winsonlin8/SpinnyKittyCommittee/ESP32/README.md

# ESP32 Firmware

This directory contains the PlatformIO project for the ESP32 microcontroller.
The firmware streams a WAV audio file and a synchronized motor/LED control file
from an SD card. Audio goes to the MAX98357A amplifier over I2S; control frames
are forwarded to the MSPM0G3507 over I2C.

## Prerequisites

- [VS Code](https://code.visualstudio.com/) with the [PlatformIO IDE extension](https://marketplace.visualstudio.com/items?itemName=platformio.platformio-ide), **or**
- PlatformIO CLI: `pip install platformio`

## Directory Structure

```
ESP32/
├── src/
│   └── main.cpp       # Full audio + control playback firmware
├── include/           # Project-level header files
├── lib/               # Local libraries
├── test/              # Unit tests
└── platformio.ini     # PlatformIO project configuration
```

## SD Card File Layout

Place these files in the root of a FAT32-formatted microSD card:

| File | Description |
|---|---|
| `/song.wav` | 44.1 kHz, 16-bit, mono PCM WAV |
| `/song.ctrl` | Binary control file — generated by `Audio Characterization/spinny_kitty_spinning_testing.py` |

The control file starts with a 16-byte `CtrlHeader` (`"CTRL"` magic, version,
frame count, frame interval in µs), followed by 5-byte `ControlFrame` structs
at 20 ms intervals. See `src/main.cpp` for the struct definitions.

## Building and Uploading

### VS Code

1. Open the `ESP32/` folder as your workspace root in VS Code.
2. PlatformIO will auto-detect `platformio.ini` and configure the project.
3. Use the bottom toolbar:
   - **Checkmark (✓)** — Build
   - **Right arrow (→)** — Upload

### CLI

Run these commands from inside the `ESP32/` directory:

```bash
pio run              # Build only
pio run -t upload    # Build and upload
```

## Serial Monitor

The firmware outputs debug info over serial at **115200 baud**. To view it:

```bash
pio device monitor
```

Or click the plug icon in VS Code's bottom toolbar.

## Wiring

### ADA254 — MicroSD Card Breakout (SPI)

| ADA254 Pin | ESP32 Pin | Notes |
|---|---|---|
| 3V | 3.3V | Power |
| GND | GND | |
| CLK | GPIO 18 | VSPI SCLK |
| DO | GPIO 19 | VSPI MISO |
| DI | GPIO 23 | VSPI MOSI |
| CS | GPIO 5 | Chip select |

---

### MAX98357A — I2S Audio Amplifier

| MAX98357A Pin | ESP32 Pin | Notes |
|---|---|---|
| VIN | 5V / VIN  | 5V gives better speaker volume than 3.3V |
| GND | GND | Common ground |
| BCLK | GPIO 26 | I2S bit clock |
| LRC / WS | GPIO 25 | I2S word select / left-right clock |
| DIN | GPIO 27 | I2S audio data from ESP32 |

---

### Speaker — 4Ω 3W

| Speaker Wire | Connect To | Notes |
|---|---|---|
| Wire 1 | MAX98357A OUT+ | Speaker output |
| Wire 2 | MAX98357A OUT- | Speaker output |

> **Important:** Do **not** connect either speaker terminal to GND.

---

### ICS-43434 — I2S Microphone

| ICS-43434 Pin | ESP32 Pin | Notes |
|---|---|---|
| 3V | 3.3V | Power — do **not** use 5V |
| GND | GND | Common ground |
| BCLK | GPIO 14 | I2S bit clock |
| LRCL | GPIO 15 | I2S word select |
| DOUT | GPIO 32 | I2S data from mic to ESP32 |
| SEL | GND | Selects LEFT channel (matches `I2S_CHANNEL_FMT_ONLY_LEFT`) |

> The `SEL` pin must be tied to **GND** for left-channel output, which matches
> the current firmware configuration.

---

### ESP32 ↔ MSPM0G3507 — I2C Communication

| ESP32 Pin | MSPM0G3507 Pin | Function | Notes |
|---|---|---|---|
| GPIO 21 | PA0 | SDA | I2C data line |
| GPIO 22 | PA1 | SCL | I2C clock line |
| GND | GND | Ground | Common ground required |

**Pull-up resistors required:**

| Signal | Value | Pull to |
|---|---|---|
| SDA | 2.2 kΩ | 3.3V  |
| SCL | 2.2 kΩ | 3.3V  |

---

### Power Notes

| Device | Power Source | Notes |
|---|---|---|
| ESP32 | USB | Used for programming and testing |
| ADA254 MicroSD Breakout | ESP32 3.3V | SD card breakout powered at 3.3V |
| MAX98357A | ESP32 5V / VIN | Better volume than powering from 3.3V |
| ICS-43434 | ESP32 3.3V | Microphone must be at 3.3V, not 5V |

## Adding Libraries

Add dependencies to `platformio.ini` under `lib_deps`:

```ini
lib_deps =
    SPI
    SD
```

PlatformIO will automatically download them on the next build.
