winsonlin8/SpinnyKittyCommittee/(list of files, drawings)

Other design files:
PCB/freerouting.dsn
PCB/temp-freerouting.dsn
