winsonlin8/SpinnyKittyCommittee/PCB/PCB.kicad_pcb

## KiCad design PCB/PCB.kicad_pcb (2026-05-05)

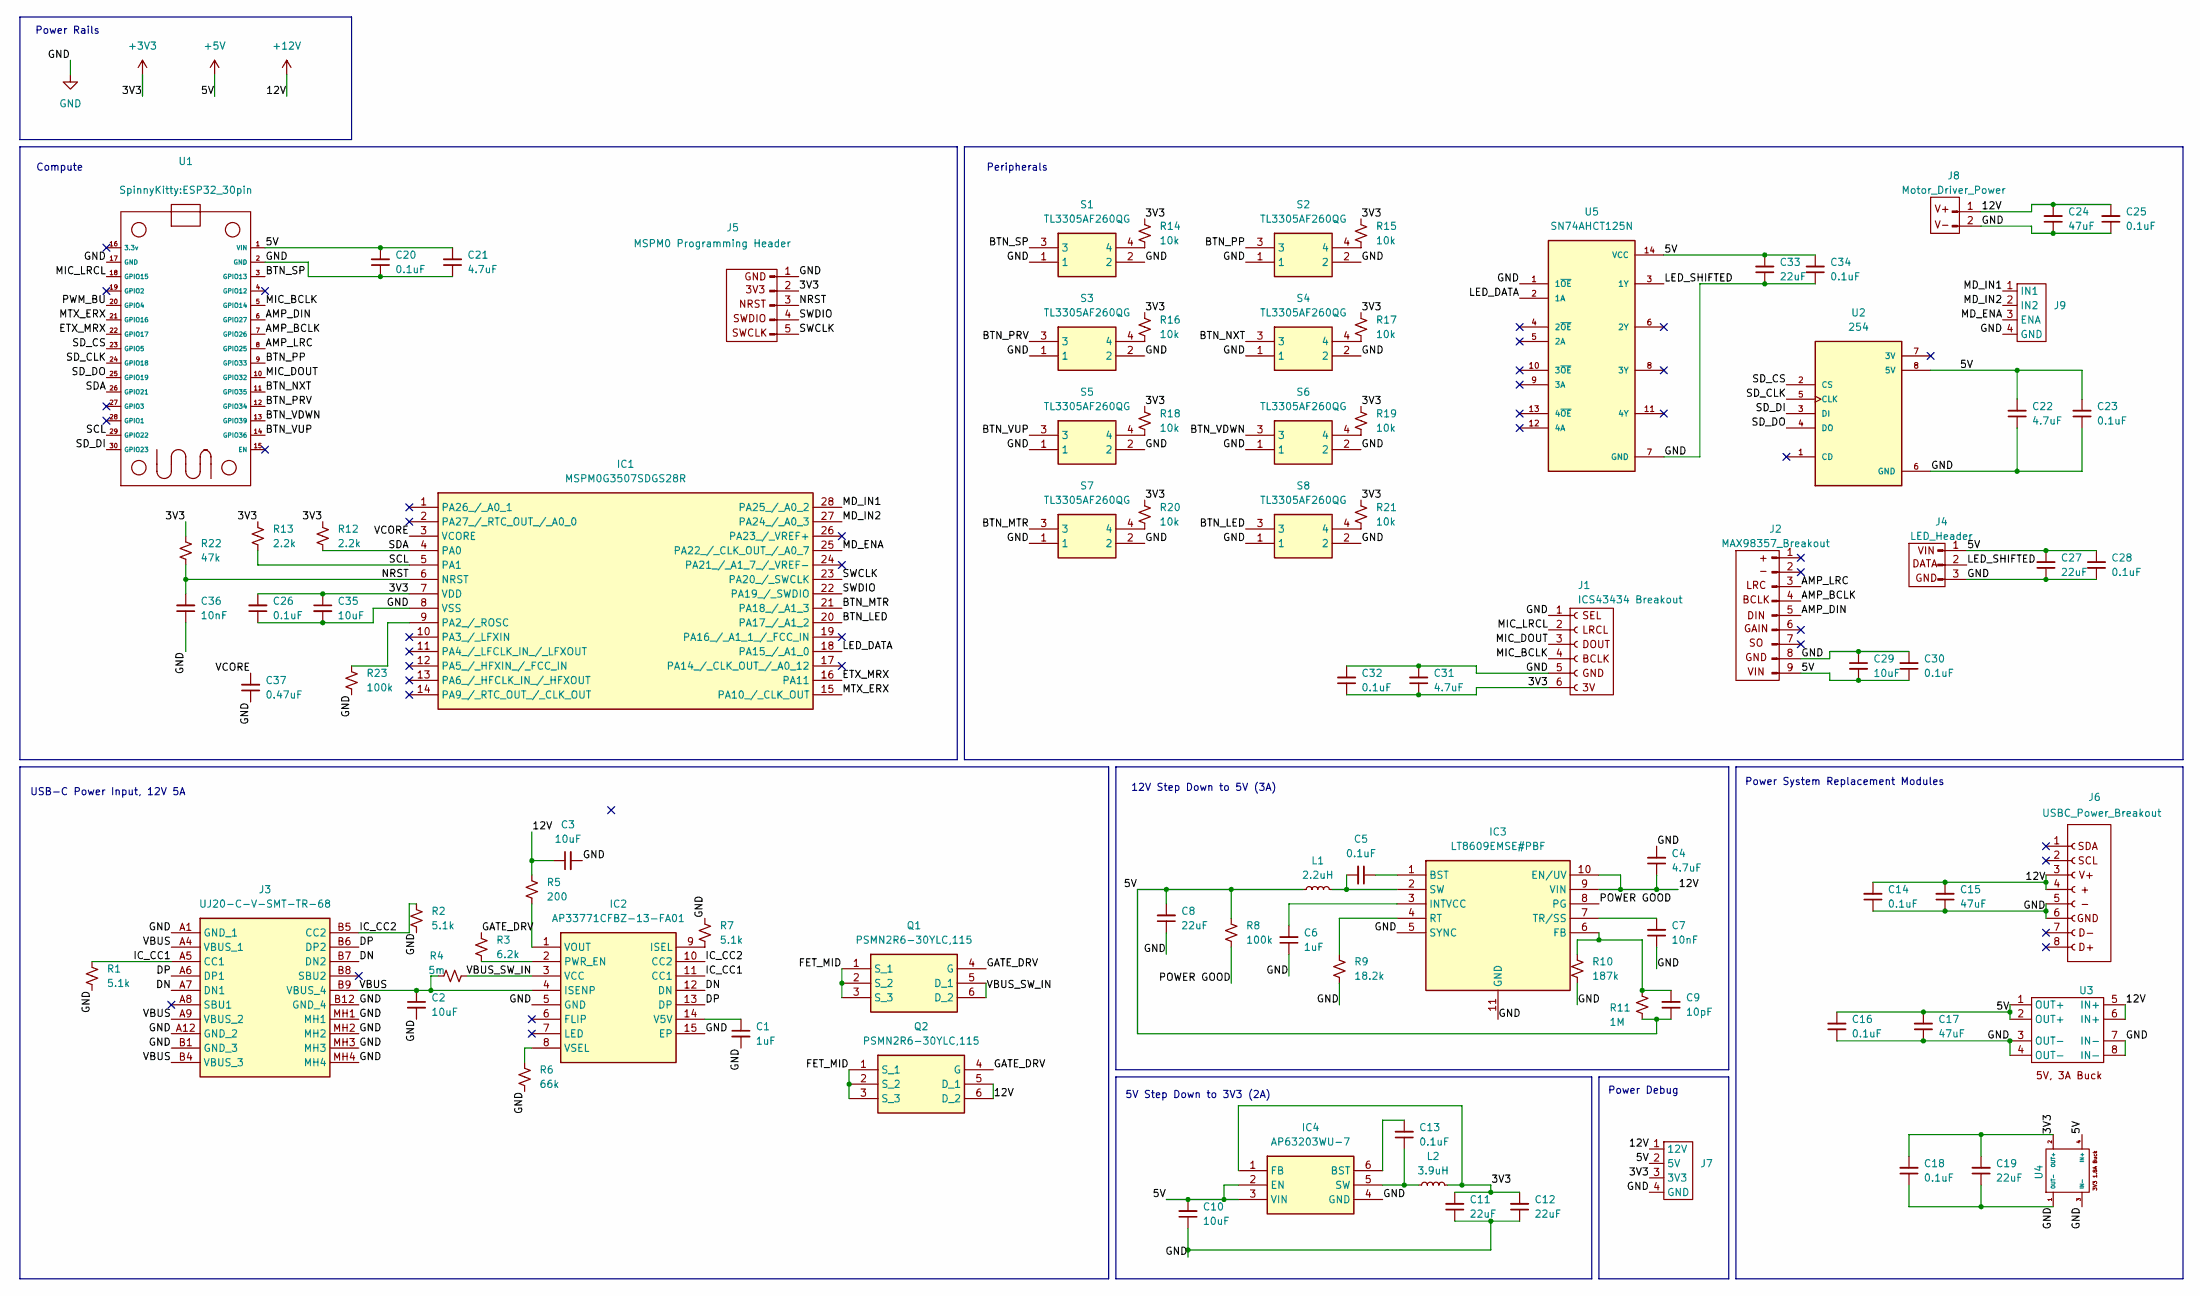
[picture p2: schematic PCB.kicad_sch]

Parts:
C1, C6: 1uF; C_0805_2012Metric_Pad1.18x1.45mm_HandSolder; Mouser Part Number 581-KGM21AR71E105JU
C2, C3, C10, C29, C35: 10uF; C_1206_3216Metric_Pad1.33x1.80mm_HandSolder; Mouser Part Number 963-BAST31LAB7106KT
C4, C21, C22, C31: 4.7uF; C_0805_2012Metric_Pad1.18x1.45mm_HandSolder; Mouser Part Number KGM21AR71E475KU
C5, C13, C14, C16, C18, C20, C23, C25, C26, C28, C30, C32, C34: 0.1uF; C_0805_2012Metric_Pad1.18x1.45mm_HandSolder; Mouser Part Number 581-KAM21BR71E104MT
C7, C36: 10nF; C_0805_2012Metric_Pad1.18x1.45mm_HandSolder; Mouser Part Number 581-08053C103JAZ2A
C8, C11, C12, C19, C27, C33: 22uF; C_1206_3216Metric_Pad1.33x1.80mm_HandSolder; Mouser Part Number 963-MSASE31LBB7226MT
C9: 10pF; C_0805_2012Metric_Pad1.18x1.45mm_HandSolder; Mouser Part Number 581-08053A100JAT2A
C15, C17, C24: 47uF; C_0805_2012Metric_Pad1.18x1.45mm_HandSolder; Mouser Part Number 810-C3216X5R1E476M
C37: 0.47uF; C_0805_2012Metric_Pad1.18x1.45mm_HandSolder; Mouser Part Number 581-08055C474K4T4A
IC1: MSPM0G3507SDGS28R; SOP50P490X110-28N; Mouser Part Number 595-MSPM0G3507SDG28R
IC2: AP33771CFBZ-13-FA01; AP33771CFBZ13FA01; Mouser Part Number 621-P33771CFBZ13FA01
IC3: LT8609EMSE#PBF; SOP50P490X110-11N; Mouser Part Number 584-LT8609EMSE#PBF
IC4: AP63203WU-7; AP63203WU7; Mouser Part Number 621-AP63203WU-7
J1: ICS43434 Breakout
J2: MAX98357_Breakout; MAX98357
J3: UJ20-C-V-SMT-TR-68; UJ20CVSMTTR68; Mouser Part Number 179-UJ20-C-V-SMTTR68
J4: LED_Header; PinHeader_1x03_P2.54mm_Vertical
J5: MSPM0 Programming Header; PinHeader_1x05_P2.54mm_Vertical
J6: USBC_Power_Breakout; USBC_POWER_BREAKOUT
J7, J9: PinHeader_1x04_P2.54mm_Vertical
J8: Motor_Driver_Power; PinHeader_1x02_P2.54mm_Vertical
L1: 2.2uH; PM5402222NLT; Mouser Part Number 673-PM5402.222NLT
L2: 3.9uH; SRR3818A3R9Y; Mouser Part Number 652-SRR3818A-3R9Y
Q1, Q2: PSMN2R6-30YLC,115; PSMN2R630YLC115; Mouser Part Number 771-PSMN2R630YLC115
R1, R2, R7: 5.1k; R_0603_1608Metric_Pad0.98x0.95mm_HandSolder; Mouser Part Number 71-TNPW06035K10FHTA
R3: 6.2k; R_0603_1608Metric_Pad0.98x0.95mm_HandSolder; Mouser Part Number 594-MCT06030C6201FP5
R4: 5m; R_2512_6332Metric_Pad1.40x3.35mm_HandSolder; Mouser Part Number 71-WSLP25125L000FEA
R5: 200; R_0603_1608Metric_Pad0.98x0.95mm_HandSolder; Mouser Part Number 594-MCT06030C2000FP5
R6: 66k; R_0603_1608Metric_Pad0.98x0.95mm_HandSolder; Mouser Part Number 279-CPF0603F66K5C1
R8: 100k; R_0603_1608Metric_Pad0.98x0.95mm_HandSolder; Mouser Part Number 594-MCT06030C1003FP5
R9: 18.2k; R_0603_1608Metric_Pad0.98x0.95mm_HandSolder; Mouser Part Number 594-MCT06030C1822FP5
R10: 187k; R_0603_1608Metric_Pad0.98x0.95mm_HandSolder; Mouser Part Number 603-RT0603FRE07187KL
R11: 1M; R_0603_1608Metric_Pad0.98x0.95mm_HandSolder; Mouser Part Number 660-RK73G1JRTTD1004F
R12, R13: 2.2k; R_0603_1608Metric_Pad0.98x0.95mm_HandSolder; Mouser Part Number 594-MCT06030C2201FP5
R14, R15, R16, R17, R18, R19, R20, R21: 10k; R_0603_1608Metric_Pad0.98x0.95mm_HandSolder; Mouser Part Number 71-TNPW060310K0FEEA
R22: 47k; R_0603_1608Metric_Pad0.98x0.95mm_HandSolder; Mouser Part Number 594-MCT06030C4702FP5
R23: 100k; R_0805_2012Metric_Pad1.20x1.40mm_HandSolder; Mouser Part Number 708-RNCF0805TKT100K
S1, S2, S3, S4, S5, S6, S7, S8: TL3305AF260QG; TL3305AF160QG; Mouser Part Number 612-TL3305AF260QG
U1: ESP32_30pin
U2: 254; MODULE_254; PARTREV Jul 31, 2013
U3: 5V 3A Buck
U4: 3V3 1.8A Buck
U5: SN74AHCT125N; DIP794W45P254L1930H508Q14; PARTREV Q

Connections:
+3V3: C11.2, C12.2, C18.2, C19.2, C26.2, C31.1, C32.1, C35.1, IC1.7 (VDD), IC4.1 (FB), J1.6 (3V), J5.2 (3V3), J7.3 (3V3), L2.2, R12.1, R13.1, R14.1, R15.1, R16.1, R17.1, R18.1, R19.1, R20.1, R21.1, R22.1, U4.2 (OUT+)
+5V: C8.2, C9.1, C10.2, C16.2, C17.2, C20.2, C21.2, C22.2, C23.2, C27.2, C28.2, C29.2, C30.1, C33.2, C34.2, IC4.2 (EN), IC4.3 (VIN), J2.9 (VIN), J4.1 (VIN), J7.2 (5V), L1.1, R8.1, R11.2, U1.1 (VIN), U2.8 (5V), U3.1 (OUT+), U3.2 (OUT+), U4.4 (IN+), U5.14 (VCC)
+12V: C3.1, C4.1, C14.2, C15.2, C24.2, C25.2, IC3.9 (VIN), IC3.10 (EN/UV), J6.3 (V+), J6.4 (+), J7.1 (12V), J8.1 (V+), Q2.5 (D_1), Q2.6 (D_2), R5.1, U3.5 (IN+), U3.6 (IN+)
/AMP_BCLK: J2.4 (BCLK), U1.7 (GPIO26)
/AMP_DIN: J2.5 (DIN), U1.6 (GPIO27)
/AMP_LRC: J2.3 (LRC), U1.8 (GPIO25)
/BTN_LED: IC1.20 (PA17_/_A1_2), S8.3
/BTN_MTR: IC1.21 (PA18_/_A1_3), S7.3
/BTN_NXT: S4.3, U1.11 (GPIO35)
/BTN_PP: S2.3, U1.9 (GPIO33)
/BTN_PRV: S3.3, U1.12 (GPIO34)
/BTN_SP: S1.3, U1.3 (GPIO13)
/BTN_VDWN: S6.3, U1.13 (GPIO39)
/BTN_VUP: S5.3, U1.14 (GPIO36)
/DN: IC2.12 (DN), J3.A7 (DN1), J3.B7 (DN2)
/DP: IC2.13 (DP), J3.A6 (DP1), J3.B6 (DP2)
/ETX_MRX: IC1.16 (PA11), U1.22 (GPIO17)
/FET_MID: Q1.1 (S_1), Q1.2 (S_2), Q1.3 (S_3), Q2.1 (S_1), Q2.2 (S_2), Q2.3 (S_3)
/GATE_DRV: Q1.4 (G), Q2.4 (G), R3.1
/IC_CC1: IC2.11 (CC1), J3.A5 (CC1), R1.1
/IC_CC2: IC2.10 (CC2), J3.B5 (CC2), R2.1
/LED_DATA: IC1.18 (PA15_/_A1_0), U5.2 (1A)
/LED_SHIFTED: J4.2 (DATA), U5.3 (1Y)
/MD_ENA: IC1.25 (PA22_/_CLK_OUT_/_A0_7), J9.3 (ENA)
/MD_IN1: IC1.28 (PA25_/_A0_2), J9.1 (IN1)
/MD_IN2: IC1.27 (PA24_/_A0_3), J9.2 (IN2)
/MIC_BCLK: J1.4 (BCLK), U1.5 (GPIO14)
/MIC_DOUT: J1.3 (DOUT), U1.10 (GPIO32)
/MIC_LRCL: J1.2 (LRCL), U1.18 (GPIO15)
/MTX_ERX: IC1.15 (PA10_/_CLK_OUT), U1.21 (GPIO16)
/NRST: C36.2, IC1.6 (NRST), J5.3 (NRST), R22.2
/POWER GOOD: IC3.8 (PG), R8.2
/PWM_BU: U1.20 (GPIO4)
/SCL: IC1.5 (PA1), R13.2, U1.29 (GPIO22)
/SDA: IC1.4 (PA0), R12.2, U1.26 (GPIO21)
/SD_CLK: U1.24 (GPIO18), U2.5 (CLK)
/SD_CS: U1.23 (GPIO5), U2.2 (CS)
/SD_DI: U1.30 (GPIO23), U2.3 (DI)
/SD_DO: U1.25 (GPIO19), U2.4 (DO)
/SWCLK: IC1.23 (PA20_/_SWCLK), J5.5 (SWCLK)
/SWDIO: IC1.22 (PA19_/_SWDIO), J5.4 (SWDIO)
/VBUS: C2.1, IC2.4 (ISENP), J3.A4 (VBUS_1), J3.A9 (VBUS_2), J3.B4 (VBUS_3), J3.B9 (VBUS_4), R4.1
/VBUS_SW_IN: IC2.3 (VCC), Q1.5 (D_1), Q1.6 (D_2), R4.2
/VCORE: C37.2, IC1.3 (VCORE)
GND: C1.2, C2.2, C3.2, C4.2, C6.1, C7.1, C8.1, C10.1, C11.1, C12.1, C14.1, C15.1, C16.1, C17.1, C18.1, C19.1, C20.1, C21.1, C22.1, C23.1, C24.1, C25.1, C26.1, C27.1, C28.1, C29.1, C30.2, C31.2, C32.2, C33.1, C34.1, C35.2, C36.1, C37.1, IC1.8 (VSS), IC2.5 (GND), IC2.15 (EP), IC3.5 (SYNC), IC3.11 (GND), IC4.4 (GND), J1.1 (SEL), J1.5 (GND), J2.8 (GND), J3.A1 (GND_1), J3.A12 (GND_2), J3.B1 (GND_3), J3.B12 (GND_4), J3.MH1, J3.MH2, J3.MH3, J3.MH4, J4.3 (GND), J5.1 (GND), J6.5 (-), J6.6 (GND), J7.4 (GND), J8.2 (V-), J9.4 (GND), R1.2, R2.2, R6.2, R7.1, R9.2, R10.2, R23.2, S1.1, S1.2, S2.1, S2.2, S3.1, S3.2, S4.1, S4.2, S5.1, S5.2, S6.1, S6.2, S7.1, S7.2, S8.1, S8.2, U1.2 (GND), U1.17 (GND), U2.6 (GND), U3.3 (OUT-), U3.4 (OUT-), U3.7 (IN-), U3.8 (IN-), U4.1 (OUT-), U4.3 (IN-), U5.1 (1~OE), U5.7 (GND)
unnamed: IC1.9 (PA2_/_ROSC), R23.1
unnamed: IC2.9 (ISEL), R7.2
unnamed: IC2.2 (PWR_EN), R3.2
unnamed: C1.1, IC2.14 (V5V)
unnamed: IC2.1 (VOUT), R5.2
unnamed: IC2.8 (VSEL), R6.1
unnamed: C5.1, IC3.1 (BST)
unnamed: C9.2, IC3.6 (FB), R10.1, R11.1
unnamed: C6.2, IC3.3 (INTVCC)
unnamed: IC3.4 (RT), R9.1
unnamed: C5.2, IC3.2 (SW), L1.2
unnamed: C7.2, IC3.7 (TR/SS)
unnamed: C13.2, IC4.6 (BST)
unnamed: C13.1, IC4.5 (SW), L2.1
unnamed: R14.2, S1.4
unnamed: R15.2, S2.4
unnamed: R16.2, S3.4
unnamed: R17.2, S4.4
unnamed: R18.2, S5.4
unnamed: R19.2, S6.4
unnamed: R20.2, S7.4
unnamed: R21.2, S8.4

Notes on the sheet:
5V Step Down to 3V3 (2A)
Peripherals
Power Debug
Compute
USB-C Power Input, 12V 5A
Power Rails
Power System Replacement Modules
12V Step Down to 5V (3A)

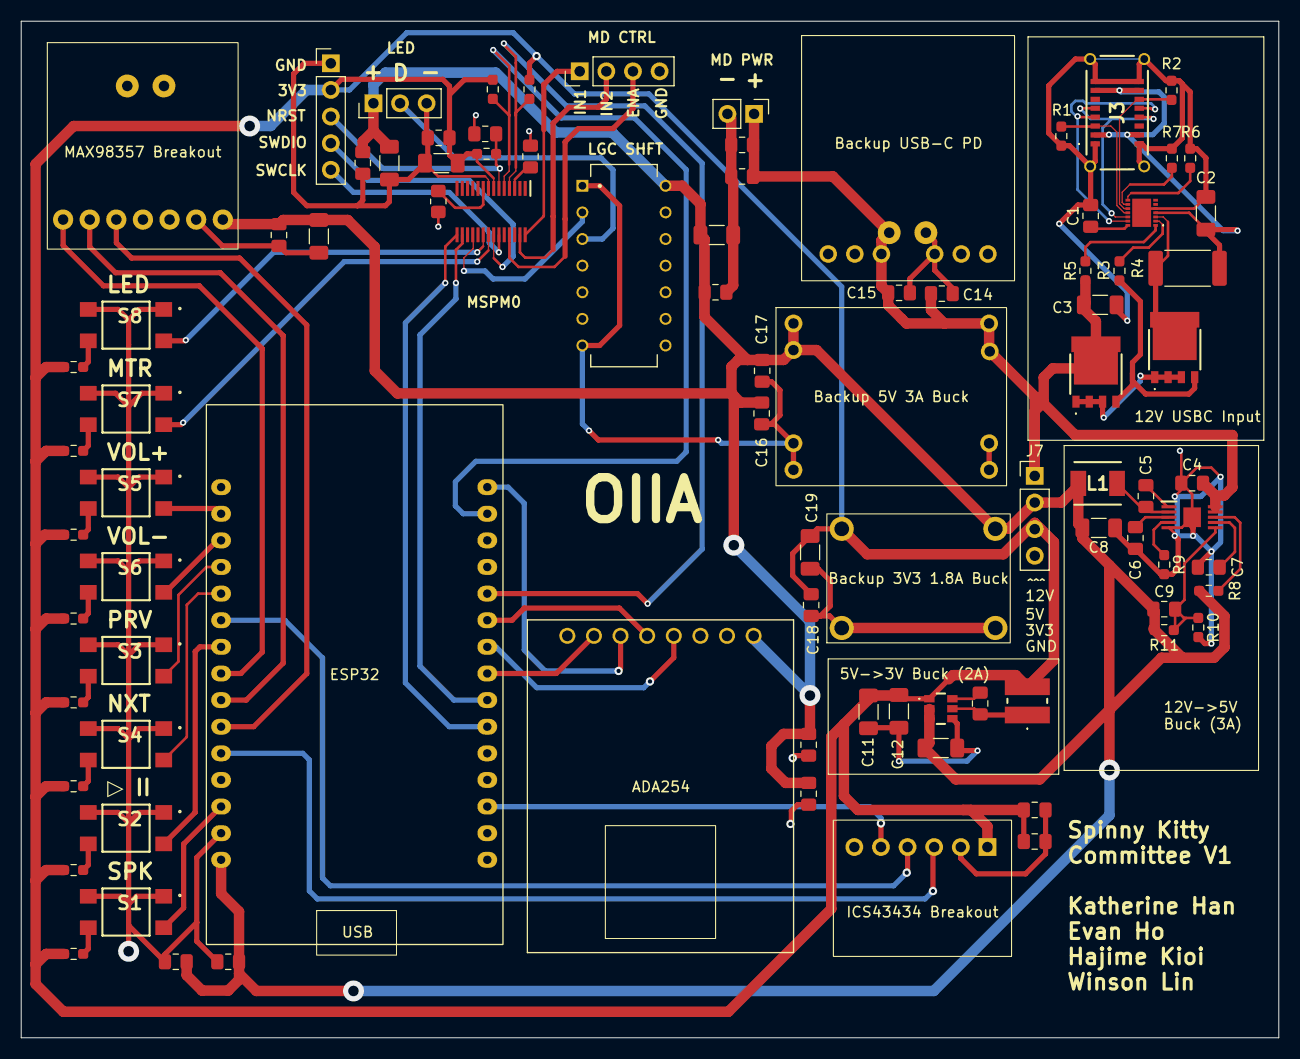
[picture p3: board PCB.kicad_pcb from above]

Board: 2 copper layers, 120.0 x 97.0 mm, 90 parts (0 on the bottom side), 66 nets.
