winsonlin8/SpinnyKittyCommittee/MSPM0/i2c_target/led_beat_params.h

#ifndef LED_BEAT_PARAMS_H
#define LED_BEAT_PARAMS_H

#include <stdint.h>

/* 5800 frames at 0.023220 s/frame */
#define LED_FRAME_COUNT   5800
#define LED_COUNT         35
#define LED_FRAME_DT_SEC  0.02321995f
#define PALETTE_SIZE      8

/*  Each row: { pos, brightness, tail_len, color_idx } */
const uint8_t led_beat_params[LED_FRAME_COUNT][4] = {
    {1, 40, 2, 0},
    {2, 59, 2, 0},
    {3, 76, 2, 1},
    {4, 75, 2, 1},
    {5, 68, 2, 1},
    {6, 76, 2, 1},
    {7, 84, 2, 1},
    {8, 80, 2, 1},
    {9, 69, 2, 1},
    {10, 68, 2, 1},
    {11, 67, 2, 1},
    {12, 63, 2, 1},
    {13, 60, 2, 1},
    {14, 58, 2, 1},
    {15, 58, 2, 1},
    {16, 58, 2, 1},
    {17, 60, 2, 1},
    {18, 61, 2, 1},
    {19, 61, 2, 1},
    {20, 60, 2, 1},
    {21, 58, 2, 1},
    {22, 57, 2, 1},
    {23, 58, 2, 1},
    {24, 60, 2, 1},
    {25, 64, 2, 1},
    {26, 65, 2, 1},
    {27, 63, 2, 1},
    {28, 62, 2, 1},
    {29, 62, 2, 1},
    {30, 64, 2, 1},
    {31, 67, 2, 1},
    {32, 66, 2, 1},
    {33, 64, 2, 1},
    {34, 64, 2, 1},
    {0, 65, 2, 1},
    {1, 65, 2, 1},
    {2, 66, 2, 1},
    {3, 68, 2, 1},
    {4, 67, 2, 1},
    {5, 65, 2, 1},
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
};

#endif
