winsonlin8/SpinnyKittyCommittee/MSPM0/i2c_target/music_data.h

#ifndef MUSIC_DATA_H
#define MUSIC_DATA_H

#include <stdint.h>

#define DATA_COUNT (6735U)
#define UPDATE_INTERVAL_MS (20U)

const uint8_t pwm_data[DATA_COUNT] = {
    40, 73, 119, 150, 150, 131, 122, 114, 104, 93, 84, 79, 74, 70, 65, 62, 
    60, 60, 60, 61, 62, 85, 105, 119, 106, 94, 87, 82, 79, 76, 73, 70, 
    68, 68, 69, 69, 68, 66, 65, 65, 65, 91, 112, 127, 112, 100, 91, 85, 
    82, 81, 81, 81, 78, 75, 85, 92, 95, 82, 72, 70, 73, 97, 112, 121, 
    108, 99, 92, 84, 78, 78, 80, 83, 83, 81, 79, 79, 80, 82, 85, 99, 
    145, 194, 225, 222, 204, 181, 157, 142, 139, 146, 164, 175, 166, 137, 126, 148, 
    170, 168, 140, 129, 150, 198, 229, 231, 206, 182, 163, 145, 123, 108, 113, 140, 
    153, 143, 127, 138, 154, 156, 135, 119, 133, 168, 186, 175, 150, 148, 164, 169, 
    154, 134, 145, 166, 166, 139, 119, 124, 143, 146, 134, 125, 163, 209, 238, 223, 
    200, 184, 171, 155, 130, 110, 106, 124, 134, 128, 106, 94, 90, 87, 81, 79, 
    95, 131, 154, 158, 139, 125, 126, 125, 124, 117, 122, 129, 126, 112, 98, 92, 
    89, 86, 84, 88, 102, 138, 161, 168, 150, 143, 144, 141, 133, 121, 112, 118, 
    122, 125, 117, 121, 128, 129, 120, 108, 112, 142, 164, 168, 146, 132, 135, 134, 
    130, 115, 113, 120, 125, 120, 113, 113, 125, 128, 126, 118, 145, 176, 193, 176, 
    154, 139, 127, 116, 107, 104, 118, 129, 132, 118, 109, 114, 122, 120, 108, 108, 
    159, 206, 234, 214, 190, 165, 139, 120, 108, 115, 142, 163, 159, 132, 123, 147, 
    169, 169, 139, 128, 154, 202, 232, 229, 205, 183, 164, 144, 125, 111, 126, 149, 
    161, 139, 125, 137, 156, 156, 130, 113, 125, 165, 187, 178, 153, 157, 172, 175, 
    150, 134, 149, 169, 165, 134, 116, 131, 150, 154, 132, 124, 149, 197, 227, 225, 
    203, 188, 175, 157, 129, 108, 112, 131, 141, 126, 106, 91, 86, 83, 82, 83, 
    125, 158, 180, 157, 139, 139, 138, 133, 115, 106, 116, 125, 128, 114, 104, 97, 
    93, 89, 85, 83, 100, 135, 161, 161, 141, 141, 143, 142, 124, 111, 104, 101, 
    99, 94, 90, 94, 106, 113, 112, 103, 120, 136, 148, 132, 117, 107, 99, 94, 
    89, 84, 83, 94, 103, 109, 106, 108, 110, 109, 106, 105, 118, 153, 178, 183, 
    162, 147, 149, 149, 147, 134, 125, 119, 115, 110, 104, 101, 98, 96, 96, 106, 
    154, 200, 229, 214, 192, 171, 149, 133, 124, 132, 158, 175, 170, 142, 132, 147, 
    167, 165, 139, 124, 138, 188, 221, 230, 205, 181, 162, 142, 119, 104, 114, 141, 
    153, 139, 124, 139, 156, 156, 126, 107, 131, 169, 189, 165, 139, 140, 159, 164, 
    147, 130, 145, 167, 165, 132, 113, 122, 145, 149, 130, 118, 142, 192, 223, 222, 
    199, 183, 170, 152, 121, 98, 98, 120, 133, 122, 99, 83, 77, 73, 70, 71, 
    100, 137, 161, 154, 136, 126, 125, 122, 116, 111, 121, 129, 126, 109, 98, 99, 
    108, 111, 107, 100, 112, 144, 167, 167, 148, 143, 144, 142, 130, 118, 114, 120, 
    122, 117, 108, 116, 124, 125, 109, 101, 119, 153, 171, 160, 140, 131, 137, 135, 
    129, 114, 105, 100, 96, 91, 89, 94, 106, 112, 108, 100, 109, 141, 165, 167, 
    145, 129, 119, 110, 99, 91, 91, 103, 114, 121, 120, 128, 134, 134, 122, 123, 
    155, 201, 231, 231, 209, 180, 149, 127, 119, 129, 154, 174, 171, 148, 135, 153, 
    169, 165, 136, 126, 147, 195, 228, 233, 209, 184, 162, 142, 119, 104, 122, 148, 
    160, 138, 124, 135, 153, 153, 128, 108, 117, 157, 180, 175, 150, 159, 173, 176, 
    148, 134, 145, 167, 164, 139, 120, 134, 152, 153, 127, 118, 153, 202, 231, 219, 
    196, 181, 168, 151, 121, 98, 106, 127, 139, 120, 100, 86, 83, 81, 78, 77, 
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
};

#endif
