winsonlin8/SpinnyKittyCommittee/(commit log)

2026-04-04 rename microsd ESP32
2026-04-04 added wiring to README
2026-04-04 added kicad pcb files
    [PCB.kicad_pcb, PCB.kicad_sch]
2026-04-08 pcb update
    [MAX98357.kicad_pcb, MAX98357.kicad_sch, PCB.kicad_sch, USBC Power Breakout.kicad_pcb, USBC Power Breakout.kicad_sch]
2026-04-08 all symbols and footprints
    [MAX98357.kicad_pcb, MAX98357.kicad_sch, PCB.kicad_pcb, PCB.kicad_sch, USBC Power Breakout.kicad_pcb, USBC Power Breakout.kicad_sch]
2026-04-10 Add files via upload
    Files for running PWM. The motor should change speed every 2s.
2026-04-10 Update README.md
    Pin documentation for running PWM
2026-04-10 Update README.md for esp32 to mspm0
2026-04-10 Update README.md
    pinout for PWM
2026-04-10 Update main.c
    PWM code
    changes between fast and slow rotation every 2s
2026-04-11 schematic for on board power system
    [PCB.kicad_pcb, PCB.kicad_sch, freerouting.dsn, temp-freerouting.dsn]
2026-04-11 backup power rail pcb
    [PCB.kicad_pcb, PCB.kicad_sch]
2026-04-11 schematic update
    [PCB.kicad_sch]
2026-04-11 drc update
    [PCB.kicad_pcb]
2026-04-12 Update README.md I2C
2026-04-13 complete pcb
    [PCB.kicad_pcb, PCB.kicad_sch]
2026-04-13 routing cleanup
    [PCB.kicad_pcb]
2026-04-13 mspm0 update
    [PCB.kicad_pcb, PCB.kicad_sch]
2026-05-03 Create final.ccs
    Final ESP32 Code
2026-05-03 Final ESP32 Code
2026-05-05 pcb backups
    [PCB.kicad_pcb, PCB.kicad_sch]
